BenBoeckle/Gfs-8-Klasse-NWT/GFS-Ben-Leonard.pptx

## Ben Böckle Leonard Koch

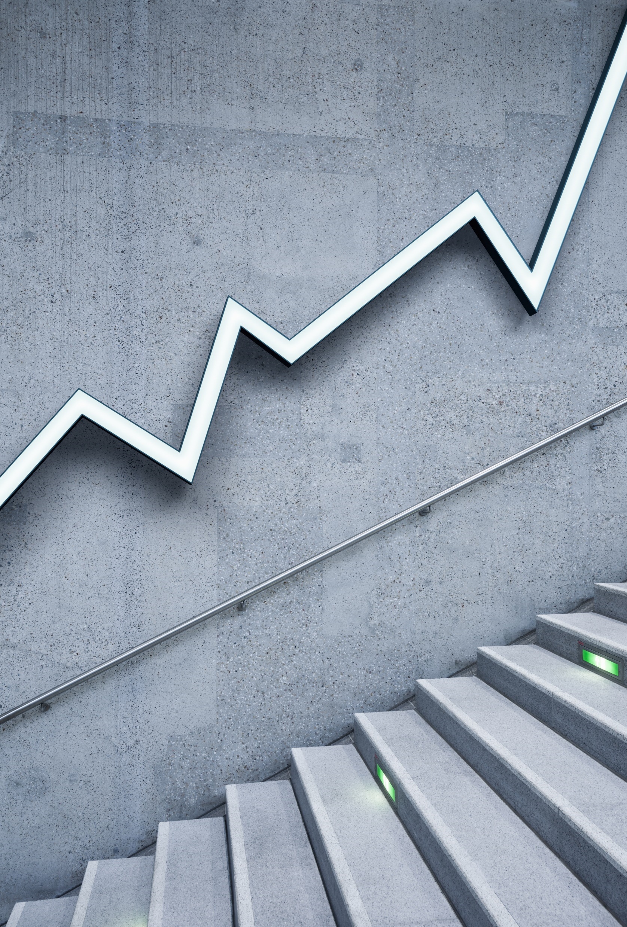
[picture p2: figure]

GFS 8. Klasse 2023

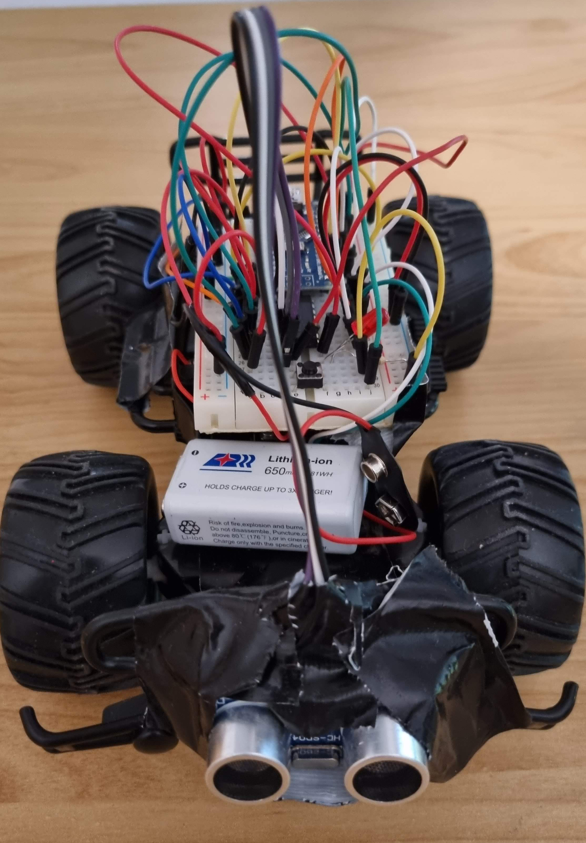
[picture p3: figure]

## Basic Stamp vs Arduino

| Basic Stamp | Arduino - Uno
Mikrocontroller | PIC16-Baureihe - 4.0 MHz | ATmega328P – 16MHz
Spannung | 5V | 5V
Programmiersprache | Basic (PBasic) | C / C++
Anzahl digitaler I/O Pins | 8 Pins | 14 Pins
Anzahl analoger Inputs | 0 | 6
PWM Pins | 0 | 6
Informationen aus dem Internet | Wenig | Sehr viele Quellen und Foren
Programmierumgebung | Basic Stamp Editor | Arduino Studio

## Abstandssensor HC-SR04

- Messung über Ultraschall
- Start mit Trigger (I/O kurz auf high)
- Sensor schickt Schall los und misst die Zeit bis das Signal zurück kommt, dann wird Echo Pin für die gemessene Dauer High
- Mikrocontroller misst Zeit des Highpegels an Echo Pin
- Entfernung: s=0,5∗V/t=0,5∗(343m/s)/t

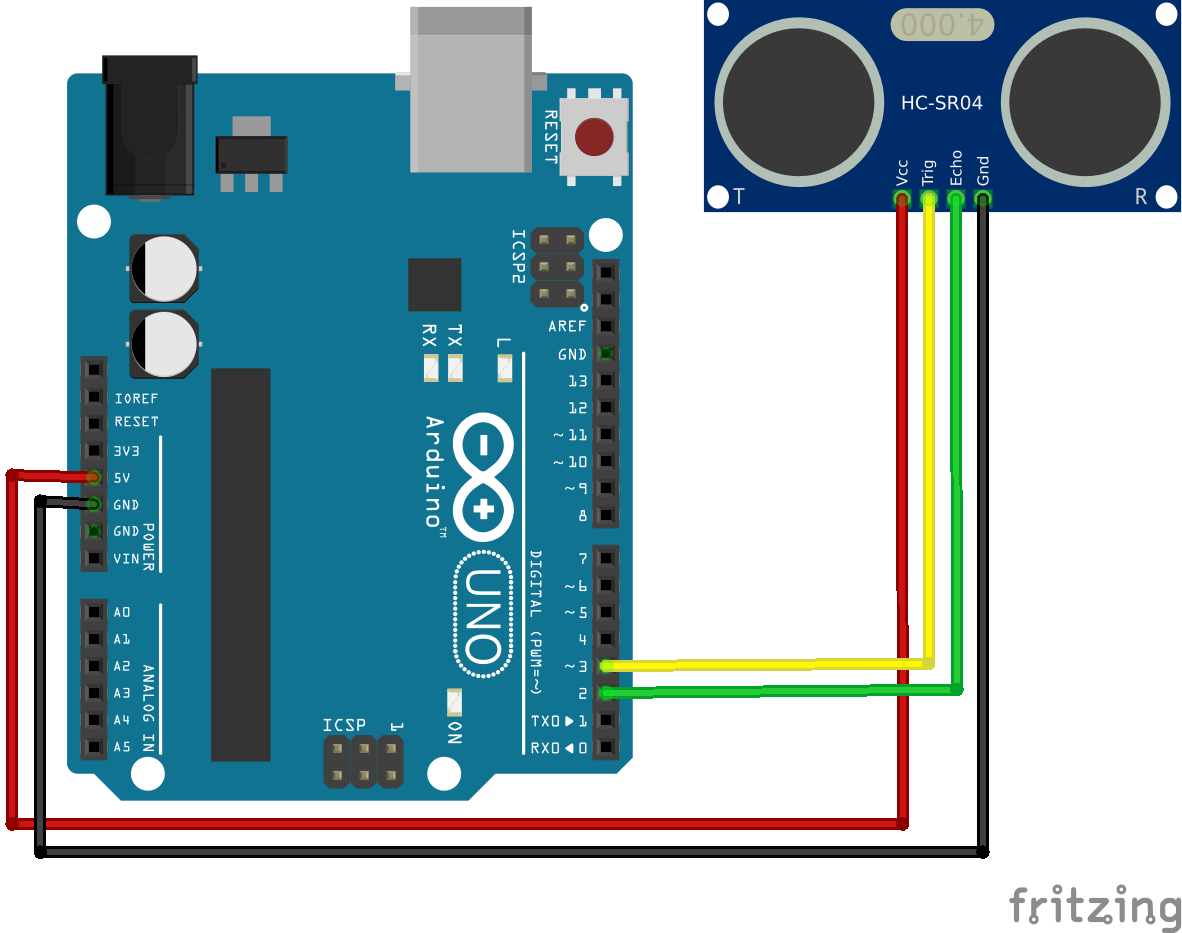
[picture p4: figure]
Uploads2ftmp2f1d55fc38 3158 4c72 b4e7 38e28e1a954c2farduinohc sr04 whdpy0fy2f
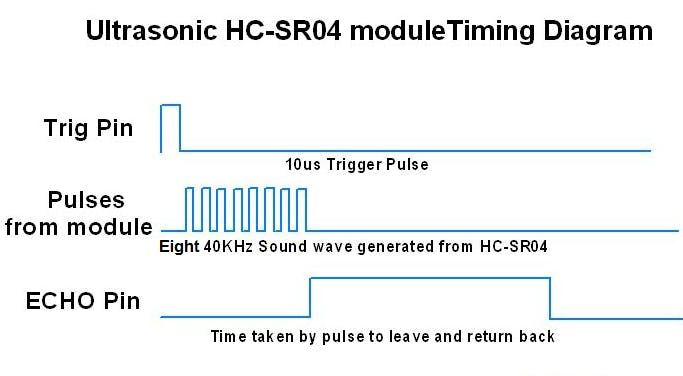
[picture p5: figure]

## Motor IC L293D

- Motor nicht direkt an den Mikrocontroller den der hat zu wenig Strom, so würde der Mikrocontroller kaputt gehen
- Durch den l293d kann man entweder 4 Motoren vorwärts oder 2 Motoren vorwärts und rückwärts
- Geschwindigkeit eines Motors kann durch PWM eingestellt werden

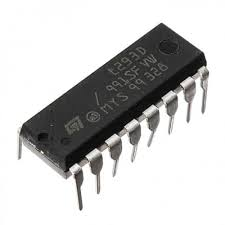
[picture p6: figure]
L293D Dual-H-Brücken-Motortreiber-IC | Kunden geben uns 9/10!
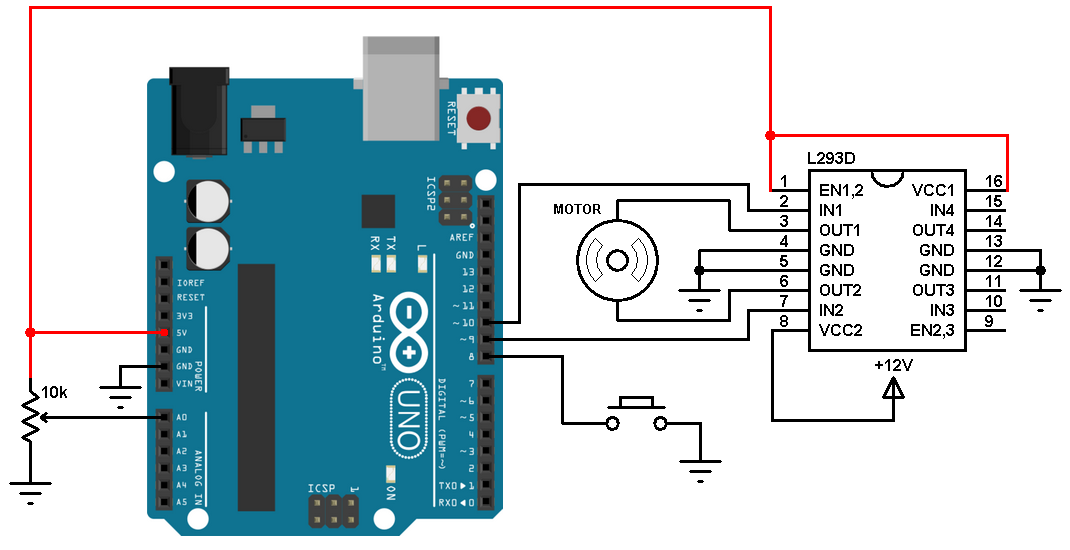
[picture p7: figure]

## Geschwindigkeit über PWM

- Signal hat immer die gleiche Frequenz (Zeit von an und aus)
- Information steckt darin wie lange das Verhältnis von an und aus ist
- Stehen wäre immer aus (0%)
- Maximale Geschwindigkeit wäre immer an(100%)

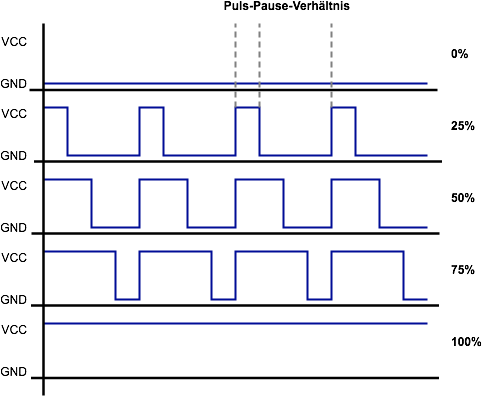
[picture p8: figure]
PWM

## Befehle

- Digitaler Ausgang: digitalWrite(Pin, Wert) Wert : High, Low
- Digitaler Eingang: digitalRead(Pin)
- PWM: analogWrite(Pin, Wert) Wert: 0…255
- Zeitmessung: pulseIn(Pin, High)

## Quellen

- https://learn.parallax.com/educators/teach/pbasic-programming-basic-stamp
- http://site.nwtf.de/wp-content/uploads/2013/12/Druckversion-Anleitung-Mikrocontroller-V3-2.pdf
- https://store.arduino.cc/products/arduino-uno-rev3
- https://create.arduino.cc/projecthub/abdularbi17/ultrasonic-sensor-hc-sr04-with-arduino-tutorial-327ff6
- https://www.elektronik-kompendium.de/sites/kom/0401111.htm
- https://www.elektronik-kompendium.de/sites/kom/0401111.htm

## Vielen Dank für die Aufmerksamkeit
